renatorobotica12-tech/WRO-2026-Grises-Jr-Mx-Future-engineers/Photos/Vehicle-Photos.md

## Vehicle Photos

| Front | Top | Right |
|:---:|:---:|:---:|
|  |  |  |
| **Front View** | **Top View** | **Right Side** |

| Left | Rear | Bottom |
|:---:|:---:|:---:|
|  |  |  |
| **Left Side** | **Rear View** | **Bottom View** |
