renatorobotica12-tech/WRO-2026-Grises-Jr-Mx-Future-engineers/(commit log)

2026-09-11 Update sensor description for Port 1
2026-09-11 Rename Dual PD Controller to Corridor PID Controller
2026-09-14 Anadir el puerto a ev3dev, el firmware actual del Nano y su documentacion
    El repositorio documentaba una version anterior a la que corre en el
    robot: Src/ solo tenia el proyecto EV3-G y el firmware I2C viejo del
    Nano. Todo el software que el robot ejecuta hoy faltaba.
    Src/ev3dev/
    Puerto completo a Python sobre ev3dev. check_hw.py, con trece
    comandos de diagnostico que resuelven en el robot lo que no se puede
    decidir desde la PC: indices de los cinco ultrasonicos, escala y
    signo del giroscopio, y recorrido real del volante. open_ard.py y
    obs_ard.py son las dos carreras. El paquete wro/ separa
    configuracion, traccion y volante, giroscopio, HuskyLens y lectura
    del Nano.
    Src/ardu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
2026-09-14 Translate the wro package comments to English
    Comments and docstrings across the wro package are now in English, so
    the reasoning behind each decision is readable by anyone looking at the
    repository.
    Identifiers are deliberately left in Spanish. Renaming them would touch
    every call site across nine modules and the three race programs, for no
    gain in clarity: what a judge or a reader needs is the explanation, not
    the variable names.
    Where a comment recorded why a number is what it is, the reasoning is
    kept and only the wording changed. Those measurements are the useful
    part: why VOLANTE_LIMITE comes from the free travel and not the forced
    one, why the ultrasonic dropout filter exists, why t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
2026-09-14 Translate the race program comments to English
    open_ard.py and obs_ard.py now document in English what each step of the
    control loop does and why it is ordered that way.
    Two explanations were rewritten rather than translated literally,
    because the original wording described how the code came to be instead
    of what it does:
    - why the drive motor is given the previous iteration's speed
    - why each sensor is read exactly once per loop
2026-09-14 Translate the Nano firmware comments to English
    All three ultrasonic hub firmwares now document in English what they do
    and how their line or packet format is laid out.
    Each file also says where it sits in the sequence, which was not written
    down anywhere before:
    ultrasonic_hub.ino oldest. One I2C transaction per sensor, and
    no validity mask, so the EV3 cannot tell a
    real 125 cm reading from a missing echo.
    ultrasonic_hub_packet.ino all five sensors in one 8-byte frame with a
    validity mask and an XOR checksum.
    ultrasonic_hub_serial.ino in use. Drops I2C for USB at 115200 baud.
    The distin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
    [ultrasonic_hub.ino, ultrasonic_hub_packet.ino, ultrasonic_hub_serial.ino]
2026-09-14 Translate config.py to English and record how each value was measured
    config.py is the file a reader goes to first, and almost all of it is
    comments. Every value now says in English what it means, and where the
    number came from.
    The reasoning is kept, not just the values. Among what is now readable:
    - why VOLANTE_LIMITE comes from the free travel and not the forced one
    (the 34 degrees of difference are the mechanism flexing against the
    stops, not usable steering)
    - the full history of VOLANTE_KP, including that the value of 10 was
    chosen while a dead ultrasonic sensor was pinning the error at +62
    - why HUSKY_RETENCION went back down from 0.3 to 0.15, with the
    measurem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
    [config.py]
2026-09-14 Translate the check_hw.py docstrings to English
    Every command in the diagnostics tool now explains in English what it
    measures and why that value cannot be decided anywhere but on the robot.
    The module docstring says what the tool is for: a handful of values
    depend on how this particular robot is wired and assembled, and guessing
    them wrong produces failures that look like software bugs.
    Several docstrings carry findings worth keeping:
    - why `mapear` needs a sensor to be both close in absolute terms AND
    lower than its own baseline, since noise alone reaches 35 cm
    - why `escala` turns a full circle instead of 90 degrees
    - why `topes` delegates to Robot.medir_topes() rather than h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
    [check_hw.py]
2026-09-14 Rewrite the ev3dev README in English, for a reader who did not build it
    The README was written as internal notes: it assumed the reader already
    knew the project's history and read as a set of instructions to the team.
    It is now written for someone opening the repository cold.
    What changed beyond the language:
    - opens with why this path exists and what it buys, rather than with
    where it came from
    - the wiring table now includes motor port D, which powers the Nano and
    was missing
    - explains why the ultrasonic validity mask matters, with the measured
    consequence of ignoring it
    - adds a "design decisions worth knowing" section collecting the
    reasoning that was previousl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
2026-09-14 Align the documentation with the robot that actually competes
    The README, the port list and the journal described an earlier version of
    the robot. A judge reading them and then opening the code would have
    found the contradiction immediately.
    mechanic/List of ports and components.md
    Was wrong on every port. The two motors were swapped, the gyroscope and
    the camera were on each other's ports, port 1 listed a colour sensor
    that is not connected, and port 4 described an I2C link that no longer
    exists. Every entry is now what `check_hw.py puertos` reports off the
    brick, with the Nano's ultrasonic pin assignment added.
    Readme.md
    Corrected against the code:
    - the controller is p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
2026-09-14 Add the control model document, and make the README render properly
    docs/Control_Model.md
    A new mathematical description of the control system, written in
    Markdown so GitHub renders the equations and so it can be reviewed in a
    diff. Every constant is traceable either to a measurement on the robot
    or to a line in config.py.
    It derives rather than asserts. Among the results:
    - the centring error is 4.21 times the lateral displacement, because
    all four side sensors move at once. The model predicts 42 for a
    10 cm displacement; measured on track it is about 40.
    - the saturation point of the proportional gain, and what each gain
    value means as a physical dist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
2026-09-14 Merge the mathematical model with the physical measurements, add vehicle mass
    The existing mathematical PDF could now be read, and it carried
    physical and mechanical work the Markdown version did not have. That
    content is merged in and kept:
    - wheel kinematics: C = pi*D = 175.93 mm, 0.4887 mm per motor degree
    - motor torque: 0.08 N.m running, 0.12 N.m stall, F = tau/r = 2.86 N
    - Ackermann geometry, with inner and outer wheel angle equations
    - diagonal sensor decomposition into lateral and forward components
    The vehicle mass of 861 g was missing everywhere, and it turns those
    torque figures into real limits:
    weight 8.45 N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
2026-09-14 Confirm the 25 degree sensor angle, drop the future improvement lists
    The angled ultrasonic sensors are mounted at 25 degrees from
    perpendicular. That is now stated as fact rather than carried as an open
    question, and the geometry is written out with the number substituted:
    1 / cos(25) = 1.103
    e = 2 * (1 + 1.103) * d = 4.21 * d
    which matches the track measurement of about 40 for a 10 cm
    displacement. The diagonal decomposition is likewise resolved to
    0.906 and 0.423 rather than left as cos(theta) and sin(theta).
    The "Future Improvements" and "Future Work" lists are removed from both
    the README and the control model. They described intentions rather than
    the robot, and the open ite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
2026-09-15 Place the team, PCB and new vehicle photographs in the README
    The six new vehicle photographs were uploaded to Vehicle-Photos.md
    without captions, as six bare img tags, so there was no record of which
    view each one was. Identified them and labelled them:
    Front cda4834c the five HC-SR04 facing the camera
    Top a8d996a3 EV3 display, Nano board and HuskyLens from above
    Right b4fe7623 profile, front to the right
    Left 0792abae profile, front to the left
    Rear 50464d5f sensor ports 1-4 and the back of the camera
    Bottom 68f1c6de gears, differential and steering linkage
    The front of the vehicle is the end with the turquoise wheels: they are
    the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
2026-09-15 Move the second recording into Videos, with git mv this time
    VID-20260826-WA0007_001.mp4 was sitting in the repository root. The
    _001 suffix is what GitHub appends when a file of that name already
    exists, so it was uploaded from the web after the first one was already
    there.
    It is not a duplicate. Read from the mvhd atom of each file:
    VID-20260826-WA0007.mp4 95.86 s timescale 90000
    VID-20260826-WA0007_001.mp4 35.78 s timescale 10000
    Different lengths and different timescales: two separate recordings.
    Both stay, as local backup in case the public video is unreachable
    during the competition.
    Moved with git mv, not from the web editor, which is what destroyed the
    first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
2026-09-18 Bring Src/ev3dev up to what is running on the brick
    The repository had the three programmes as they stood before the parking
    work, and the brick has moved a long way since: the exit manoeuvre, its
    camera filter and straightening phase, and the entry programme, none of
    which existed here.
    New:
    salida.py exit from the bay, side fixed in config
    salida_libre.py the same, choosing the free side from the sensors
    salida2.py the simpler one-reverse alternative
    entrada.py entry: camera trigger, gyro-controlled reverse in,
    as many attempts as it takes
    Updated: check_hw.py, obs_ard.py, open_ard.py, the README, and in wro/
    config.py, robot.py and ultraso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
    [check_hw.py, config.py, entrada.py, obs_ard.py, open_ard.py, robot.py, salida.py, salida2.py]
2026-09-18 Add the vehicle photographs as files in Photos/
    Until now this repository held no image at all. Photos/Team-Photos and
    Photos/Vehicle-Photos.md embed their pictures from GitHub's attachment
    storage, which is fine on the website and gives nothing to anyone who
    clones the repository, mirrors it, or reads it offline.
    These six are the photographs that were sitting loose in the root of the
    other repository. Two of them are identified: -4 is the underside,
    showing the steering rack and the angle of the two front ultrasonics,
    and the unnumbered one is the left side with the camera mast. The rest
    keep the names they arrived with rather than being given views they
    might not have.
    V-Photos comes ac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
2026-09-18 Remove the team photograph
    It was in two places, both now gone: the Photos/Team-Photos file, whose
    only content was the embed, and the "Team Photo" section of the README.
    Both pointed at the same picture.
    What this does not do, and cannot: the image itself sits in GitHub's
    attachment storage, not in this repository. Removing the references
    takes it off the pages; anyone holding the direct link still reaches
    it. Taking it down for good means deleting the attachment from the
    comment or issue it was uploaded through.
